jk1mly/pcb-atom-tnc/README.md

# pcb-atom-tnc

M5 Atomモジュールを使用したFX.25対応TNCの基板
ハムフェア2023でPRUGブースにて展示＋少量頒布
