jk1mly/pcb-atom-tnc/tnc-atom-sch.pdf

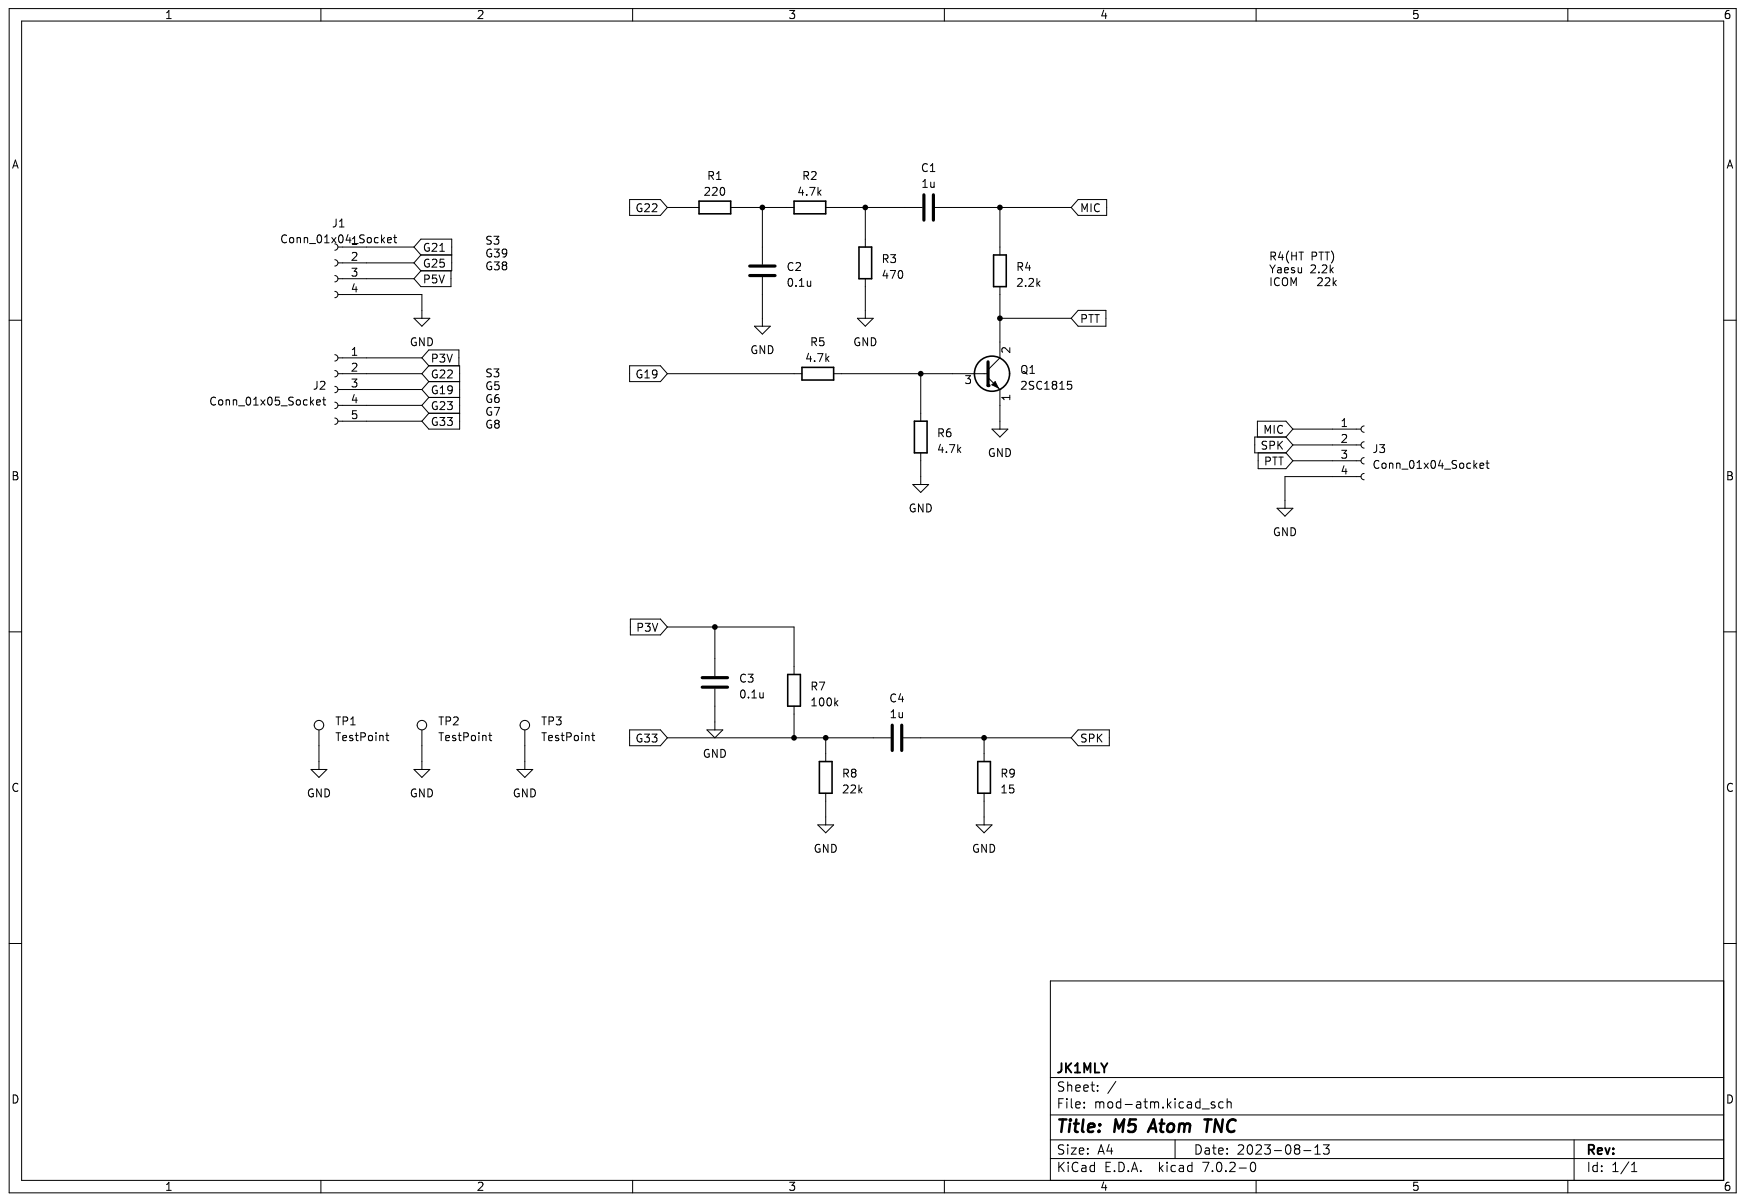
[picture p5: page 1]
