jk1mly/pcb-atom-tnc/mod-atm.kicad_pcb

## KiCad design mod-atm.kicad_pcb (2023-08-13)

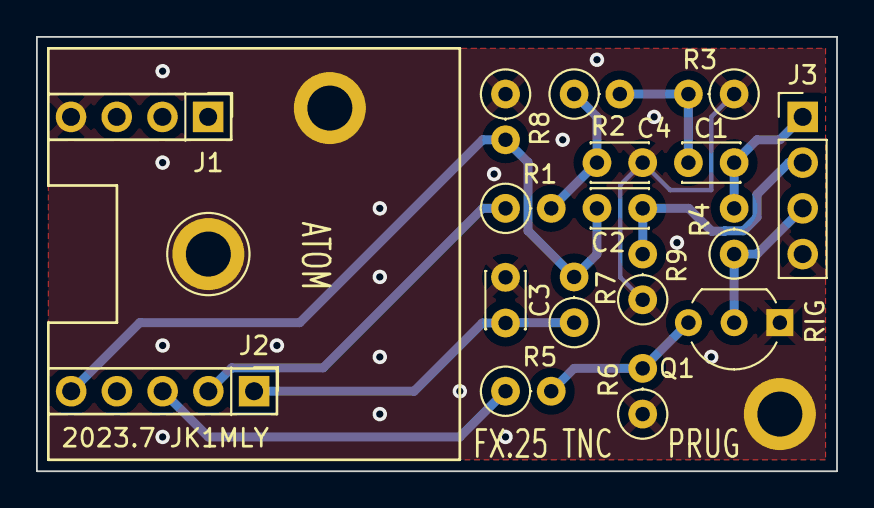
[picture p6: board mod-atm.kicad_pcb from above]

Board: 2 copper layers, 44.4 x 24.1 mm, 20 parts (0 on the bottom side), 11 nets.

Parts:
C1, C2, C3, C4: C; C_Disc_D3.0mm_W2.0mm_P2.54mm
J1, J3: Conn_01x04_Socket; PinHeader_1x04_P2.54mm_Vertical
J2: Conn_01x05_Socket; PinHeader_1x05_P2.54mm_Vertical
Q1: 2SC1815; TO-92_Inline_Wide
R1, R2, R3, R4, R5, R6, R7, R8, R9: R; R_Axial_DIN0207_L6.3mm_D2.5mm_P2.54mm_Vertical
TP1, TP2, TP3: TestPoint; TestPoint_Plated_Hole_D3.0mm

Connections:
G19: J2.3, R5.1
G22: J2.2, R1.1
G33: C4.1, J2.5, R7.2, R8.2
GND: C2.2, C3.2, J1.4, J3.4, Q1.1 (E), R3.1, R6.1, R8.1, R9.1, TP1.1, TP2.1, TP3.1
MIC: C1.2, J3.1, R4.2
unnamed: C1.1, R2.2, R3.2
unnamed: C2.1, R1.2, R2.1
unnamed: Q1.3 (B), R5.2, R6.2
P3V: C3.1, J2.1, R7.1
PTT: J3.3, Q1.2 (C), R4.1
SPK: C4.2, J3.2, R9.2
